buha/pir-trigger/README.md

# pir-trigger
Camera trigger using PIR sensor

# Specifications
* 2.7" Eink screen
* PIR sensor
* Light sensor
* Camera focus and shutter control (any camera with 2.5mm native or adapted cable release)
* 5 way navigational buttons
* \>1 year on a 3V CR2477
* Weatherproof
