buha/pir-trigger/doc/2.13inch_e-Paper_HAT_Schematic.pdf

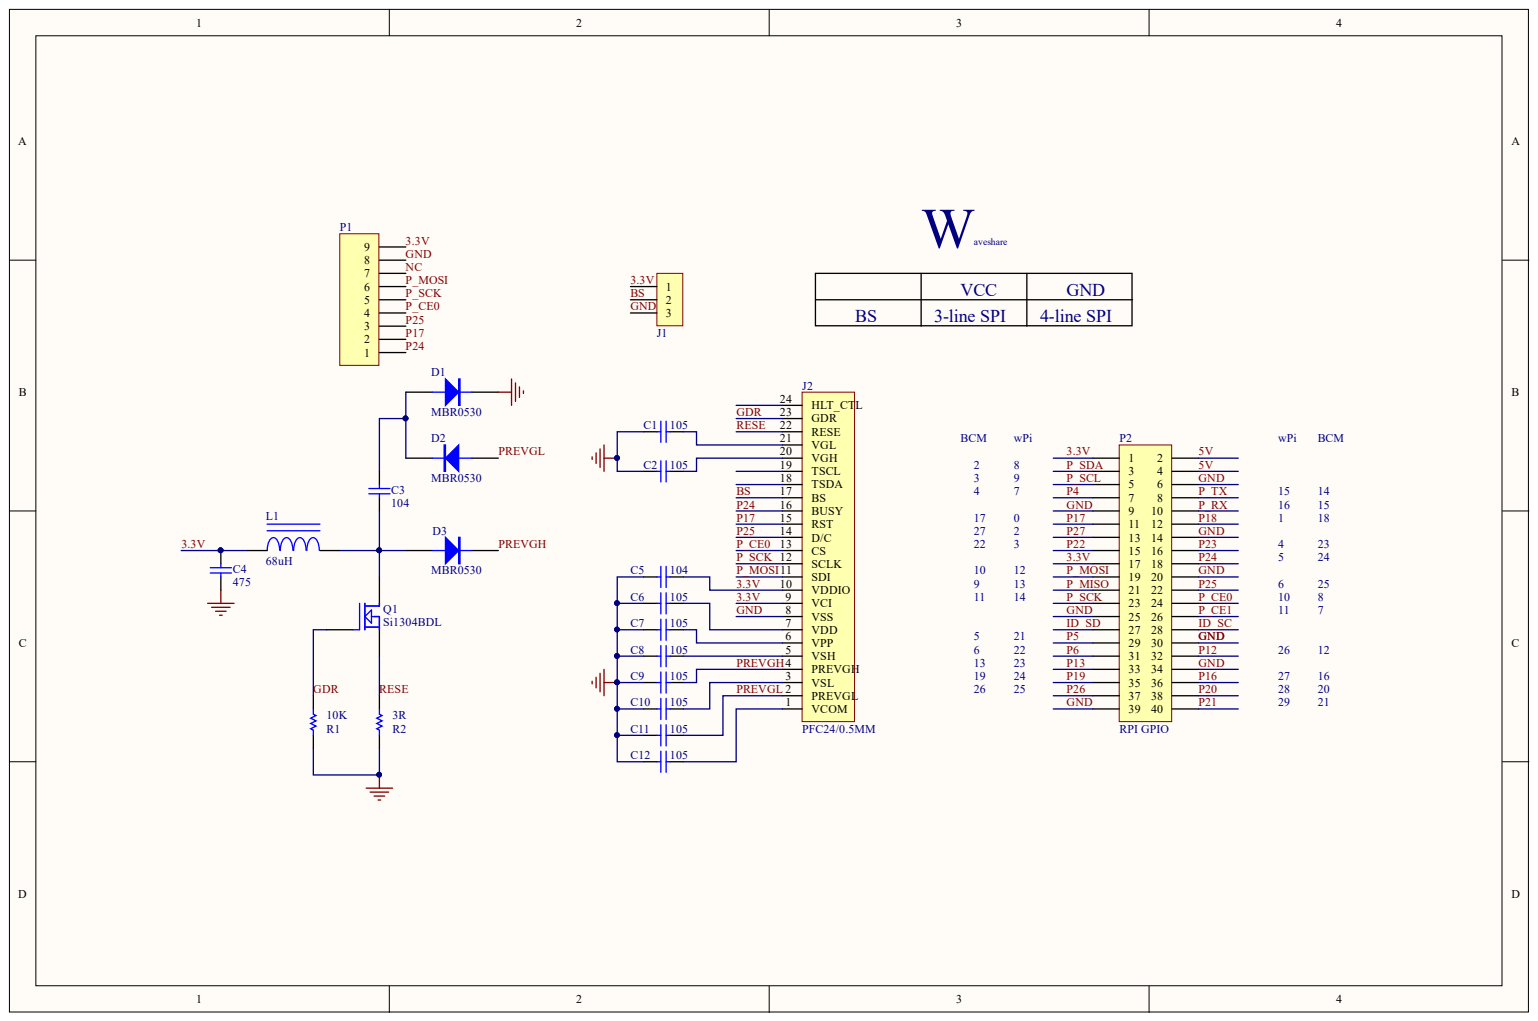
[picture p1: page 1]

PRE V G L | 2
