buha/pir-trigger/pcb/sim/st-design.asc

C1: cap; 47nF
C2: cap; 22µF
C3: cap; 22µF
C4: cap; 47nF
C5: cap; 10nF
C6: cap; 10nF
C8: cap; 3.5nF
D1: diode
R1: res; 680k
R2: res; 13k
R3: res; 13k
R4: res; 56k
R5: res; 680k
R6: res; 220k
R7: res; 470k
R8: res; 470k
R9: res; 220k
U1: AD8629
U2: AD8629
U3: LT1018
U4: LT1018
V1: voltage; PWL file=Z:\home\dari\Work\pir-trigger\pcb\sim\sensor-output.csv
V2: voltage; 3
Named nets: 0, PIR, VCC, stage1, stage2, stage3h, stage3l
.tran 0 100 0
.step param R1 list 10k 100k
