buha/pir-trigger/pcb/sim/ti-design.asc

C1: cap; 0.01µF
C2: cap; 33µF
C3: cap; 3.3µF
C4: cap; 1nF
C5: cap; 0.1µF
C6: cap; 0.1µF
C7: cap; 0.1µF
D1: diode
R1: res; 10k
R2: res; 6.81k
R3: res; 68.1k
R4: res; 1.3Meg
R5: res; 15Meg
R6: res; 15Meg
R7: res; 15Meg
R8: res; 15Meg
R9: res; 15Meg
U1: AD8629
U2: AD8629
U3: LT1018
U4: LT1018
V1: voltage; PWL file=Z:\home\dari\Work\pir-trigger\pcb\sim\sensor-output.csv
V2: voltage; 3
Named nets: 0, PIR, VCC, stage1, stage2, stage3h, stage3l
.tran 0 100 0
