buha/pir-trigger/pcb/pir.kicad_pcb

## KiCad design pcb/pir.kicad_pcb (2018-02-23)

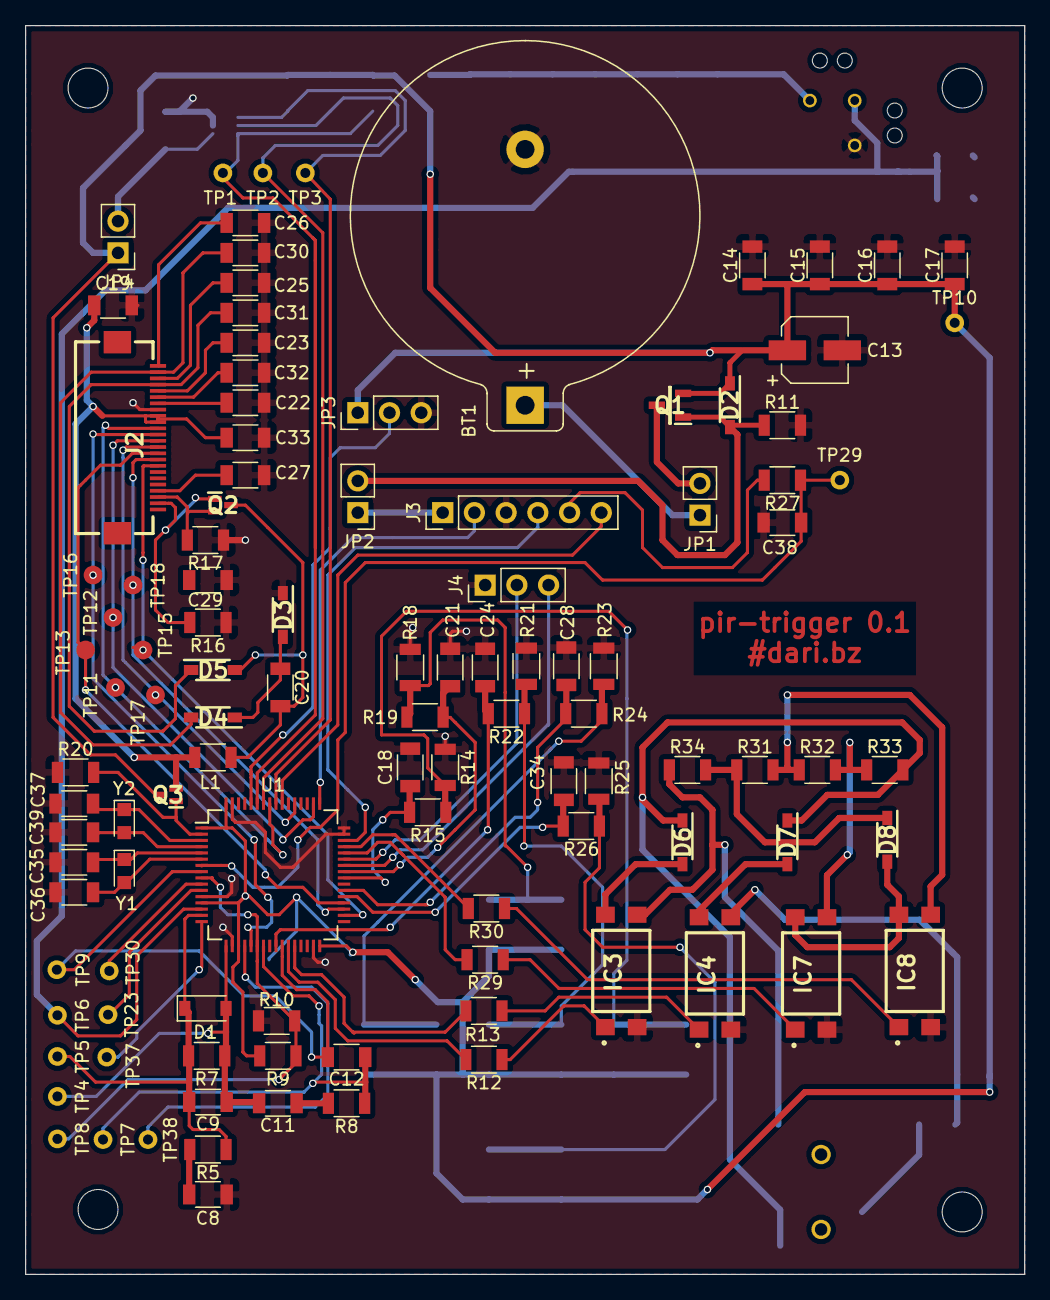
[picture p2: board pir.kicad_pcb from above]

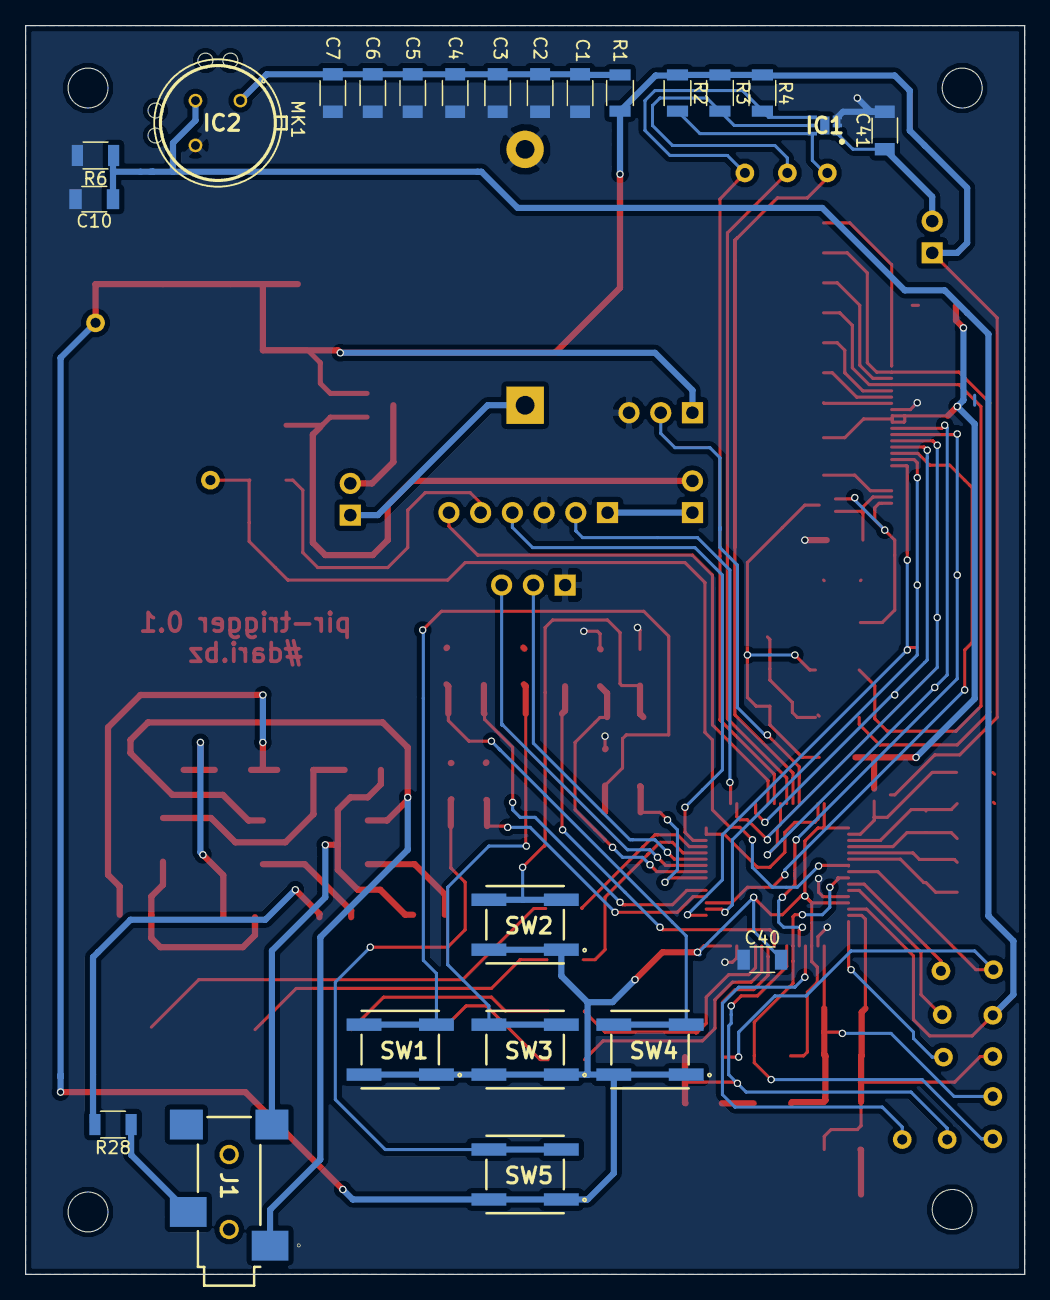
[picture p3: board pir.kicad_pcb from below]

Board: 2 copper layers, 80.0 x 100.0 mm, 133 parts (25 on the bottom side), 84 nets.

Parts:
BT1: CR2477 3V Battery; Keystone_105_1x2430-CoinCell
C1: 100μF; C_1206
C2, C14: 10μF; C_1206
C3, C15: 1μF; C_1206
C4, C16: 0.1μF; C_1206
C5, C17: 0.01μF; C_1206
C6: 1000pF; C_1206
C7: 100pF; C_1206
C8: 22μF; C_1206
C9, C12: 47nF; C_1206
C10: 3.3nF; C_1206
C11: 22uF; C_1206
C13: 100u; CP_Elec_5x5.3
C18, C21, C24, C28, C34, C38, C40: 100nF; C_1206
C19, C31: 4.7uF; C_1206
C20, C33: 100n; C_1206
C22, C23, C25, C26, C27, C29, C30, C32: 1uF; C_1206
C35, C36, C37, C39: 12pF; C_1206
C41: 0.1uF; C_1206
D1: 1N4148X-TP; D_SOD-123
D2, D3, D4, D5, D6, D7, D8: MBR0530; SOD3716X135N
IC1: MAX44009EDT+T; SON65P200X200X65-7N
IC2: IRA-S210ST01
IC3, IC4, IC7, IC8: EL817S
J1: SJ-2523-SMT-TR
J2: GDEW027W3; FH12A-24S-0.5SH
J3: SWD; Pin_Header_Straight_1x06_Pitch2.54mm
J4: UART; Pin_Header_Straight_1x03_Pitch2.54mm
JP1, JP2, JP4: Jumper; Pin_Header_Straight_1x02_Pitch2.54mm
JP3: Jumper_NC_Dual; Pin_Header_Straight_1x03_Pitch2.54mm
L1: 68uH; L_1206
MK1: IML-0688
Q1: SI2323DS; SOT95P237X112-3N
Q2, Q3: RE1C002UN; SOT50P160X85-3N
R1: 0; R_1206
R2, R3, R4, R15, R16, R19, R20, R22, R24, R26: 10k; R_1206
R5, R8: 13k; R_1206
R6: 56k; R_1206
R7: 680k; R_1206
R9, R10: 1M; R_1206
R11: 3.3K; R_1206
R12, R13, R28, R29, R30, R34: 150; R_1206
R14, R18, R21, R23, R25: 100k; R_1206
R17: 0.47; R_1206
R27: 1K; R_1206
R31: 36k; R_1206
R32: 2.9k; R_1206
R33: 2.2k; R_1206
SW1, SW2, SW3, SW4, SW5: SW_DPST-KSC931; KSC8(J)
TP1, TP2, TP3, TP4, TP5, TP6, TP7, TP8, TP9, TP10, TP23, TP29, TP30, TP37, TP38: TEST; Measurement_Point_Round-TH_Small
TP11, TP12, TP13, TP15, TP16, TP17, TP18: TEST; Measurement_Point_Round-SMD-Pad_Small
U1: STM32L476RETx; LQFP-64_10x10mm_Pitch0.5mm
Y1, Y2: 32 Mhz; Crystal_SMD_2012-2pin_2.0x1.2mm_HandSoldering

Connections:
/battery/Debugger3V3: J3.1, JP2.1
/camera/FOCUS: R12.2, U1.27
/camera/PANAFOCUS: R30.2, U1.45
/camera/PANASHUTTER: R29.2, U1.44
/camera/SHUTTER: R13.2, U1.28
/sensor/Ambient: IC1.4, R4.2, TP3.1, U1.56
/sensor/OPAMP1+: C10.1, IC2.2, R6.1, TP6.1, U1.14
/sensor/OPAMP1-: C9.2, D1.1, R5.1, R7.2, TP5.1, U1.15
/sensor/OPAMP1OUT: C9.1, C11.2, D1.2, R7.1, TP4.1, U1.17
/sensor/OPAMP2+: R9.1, R10.2, TP8.1, U1.9, U1.22
/sensor/OPAMP2-: C12.1, R8.1, TP7.1, U1.23
/sensor/OPAMP2OUT: C12.2, TP9.1, U1.8, U1.26
/sensor/SCL: IC1.5, R3.2, TP2.1, U1.58
/sensor/SDA: IC1.6, R2.2, TP1.1, U1.59
/soc/Down: C34.2, R26.2, U1.37
/soc/EINK_BS: J2.8, TP15.1, U1.34
/soc/EINK_BUSY: J2.9, TP18.1, U1.35
/soc/EINK_CS: J2.12, TP12.1, U1.50
/soc/EINK_D/C: J2.11, TP17.1, U1.53
/soc/EINK_MOSI: J2.14, TP11.1, U1.57
/soc/EINK_PWR: Q3.1, R20.2, U1.2
/soc/EINK_RST: J2.10, TP13.1, U1.36
/soc/EINK_SCK: J2.13, TP16.1, U1.21
/soc/Left: C18.2, R15.2, U1.40
/soc/OK: C24.2, R22.2, U1.25
/soc/Right: C28.2, R24.2, U1.38
/soc/Up: C21.2, R19.2, U1.41
/user/EINK_VCC: C19.1, C33.1, J2.15, J2.16, L1.1, Q3.2
/user/GDR: J2.2, Q2.1, R16.2
/user/PREVGH: C31.2, D5.1, J2.21
/user/PREVGL: C30.2, D4.2, J2.23
/user/RESE: J2.3, Q2.2, R17.2
Earth: BT1.2, C1.2, C2.2, C3.2, C4.2, C5.2, C6.2, C7.2, C8.2, C10.2, C13.2, C14.2, C15.2, C16.2, C17.2, C18.1, C19.2, C21.1, C22.1, C23.1, C24.1, C25.1, C26.2, C27.1, C28.1, C29.2, C30.1, C31.1, C32.1, C33.2, C34.1, C35.1, C36.1, C37.1, C38.1, C39.1, C40.1, C41.2, D3.1, IC1.2, IC1.3, IC2.3, IC3.2, IC4.2, IC7.2, IC8.2, J2.17, J3.3, J4.1, JP3.3, R6.2, R10.1, R11.2, R14.1, R16.1, R17.1, R18.1, R20.1, R21.1, R23.1, R25.1, U1.12, U1.18, U1.31, U1.47, U1.48, U1.63
unnamed: BT1.1, JP1.1
unnamed: C1.1, C2.1, C3.1, C4.1, C5.1, C6.1, C7.1, IC2.1, R1.1
unnamed: C8.1, R5.2
unnamed: C11.1, R8.2
unnamed: C20.1, D3.2, D4.1
unnamed: C20.2, D5.2, L1.2, Q2.3
unnamed: C22.2, J2.18
unnamed: C23.2, J2.20
unnamed: C25.2, J2.22
unnamed: C26.1, J2.24
unnamed: C27.2, J2.4
unnamed: C32.2, J2.19
unnamed: C35.2, U1.5, Y1.1
unnamed: C36.2, U1.6, Y1.2
unnamed: C37.2, U1.3, Y2.1
unnamed: C38.2, R27.1, TP29.1, U1.7
unnamed: C39.2, U1.4, Y2.2
unnamed: C41.1, IC1.1, JP4.2
unnamed: D2.2, JP2.2, Q1.1, R11.1
unnamed: D6.2, IC3.4
unnamed: D7.2, IC4.4
unnamed: D8.1, R31.1, R34.2
unnamed: D8.2, IC7.4, IC8.4
unnamed: IC3.1, R12.1
unnamed: IC4.1, R13.1
unnamed: IC4.3, R28.2
unnamed: IC7.1, R29.1
unnamed: IC7.3, R32.2, R33.1
unnamed: IC8.1, R30.1
unnamed: IC8.3, R31.2, R32.1
unnamed: JP1.2, Q1.3
unnamed: JP3.2, U1.60
unnamed: R14.2, R15.1, SW1.2, SW1.3
unnamed: R18.2, R19.1, SW2.2, SW2.3
unnamed: R21.2, R22.1, SW3.2, SW3.3
unnamed: R23.2, R24.1, SW4.2, SW4.3
unnamed: R25.2, R26.1, SW5.2, SW5.3
unnamed: TP23.1, U1.11
unnamed: TP30.1, U1.10
unnamed: TP37.1, U1.16
unnamed: TP38.1, U1.20
RING: IC3.3, J1.2, R34.1
RX: J4.2, U1.43
SHIELD: D6.1, D7.1, J1.1, R33.2
SWCLK: J3.2, U1.49
SWDIO: J3.4, U1.46
SWO: J3.6, U1.55
TIP: J1.3, R28.1
TX: J4.3, U1.42
VCC: C13.1, C14.1, C15.1, C16.1, C17.1, C40.2, D2.1, JP3.1, JP4.1, Q1.2, Q3.3, R1.2, R2.1, R3.1, R4.1, R9.2, SW1.1, SW1.4, SW2.1, SW2.4, SW3.1, SW3.4, SW4.1, SW4.4, SW5.1, SW5.4, TP10.1, U1.1, U1.13, U1.19, U1.32, U1.64
nRESET: J3.5, R27.2
