buha/pir-trigger/firmware/stm32l476re/stm32l476re.ioc

Mcu.UserName=STM32L476RETx
PA0.GPIO_Label=OPAMP1+
PA0.Signal=OPAMP1_VINP
PA1.GPIO_Label=OPAMP1-
PA1.Signal=OPAMP1_VINM
PA10.Signal=USART1_RX
PA11.GPIO_Label=PANASHUTTER
PA11.Signal=GPIO_Output
PA12.GPIO_Label=PANAFOCUS
PA12.Signal=GPIO_Output
PA3.Signal=OPAMP1_VOUT
PA5.GPIO_Label=SCK
PA5.Signal=SPI1_SCK
PA6.GPIO_Label=OPAMP2+
PA6.Signal=OPAMP2_VINP
PA7.GPIO_Label=OPAMP2-
PA7.Signal=OPAMP2_VINM
PA8.GPIO_Label=KEY_UP
PA8.Signal=GPXTI8
PA9.Signal=USART1_TX
PB0.GPIO_Label=OPAMP2OUT
PB0.Signal=OPAMP2_VOUT
PB1.GPIO_Label=FOCUS
PB1.Signal=GPIO_Output
PB13.GPIO_Label=EINK_BS
PB13.Signal=GPIO_Input
PB14.GPIO_Label=EINK_BUSY
PB14.Signal=GPIO_Input
PB15.GPIO_Label=EINK_RST
PB15.Signal=GPIO_Output
PB2.GPIO_Label=SHUTTER
PB2.Signal=GPIO_Output
PB5.GPIO_Label=MOSI
PB5.Signal=SPI1_MOSI
PB6.GPIO_Label=SCL
PB6.Signal=I2C1_SCL
PB7.GPIO_Label=SDA
PB7.Signal=I2C1_SDA
PC0.GPIO_Label=OPAMP2OUT
PC0.Signal=ADCx_IN1
PC1.GPIO_Label=OPAMP2+
PC1.Signal=ADCx_IN2
PC12.GPIO_Label=EINK_DC
PC12.Signal=GPIO_Input
PC13.GPIO_Label=EINK_PWR
PC13.Signal=GPIO_Output
PC5.GPIO_Label=KEY_OK
PC5.Signal=GPXTI5
PC6.GPIO_Label=KEY_DOWN
PC6.Signal=GPXTI6
PC7.GPIO_Label=KEY_RIGHT
PC7.Signal=GPXTI7
PC9.GPIO_Label=KEY_LEFT
PC9.Signal=GPXTI9
