buha/pir-trigger/firmware/Src/input.h

/*
 * input.h
 *
 *  Created on: 14 Mar 2018
 *      Author: dari
 */

#ifndef _INPUT_H_
#define _INPUT_H_

typedef enum
{
	KEY_OK = 28,
	KEY_UP = 103,
	KEY_LEFT = 105,
	KEY_RIGHT = 106,
	KEY_DOWN = 108
} input_t;

#endif /* _INPUT_H_ */
