buha/pir-trigger/(commit log)

2018-02-03 KiCad project files and some components
    At this point it is not certain if I go with CC2540. EFR SoCs maybe?
    [battery.sch, camera.sch, pir.kicad_pcb, pir.sch, sensor.sch, soc.sch]
2018-02-03 Replaced CC2540F256RHAT with CC2541F128RHAT
    CC2540F256RHAT has a useless USB interface.
    CC2541F128RHAT has better radio power consumption and reduced flash,
    I don't need 256KB. Fingers crossed for some samples from TI.
    EFR32 Blue Gecko was the best alternative so far but I opted for TI
    because of its free CCS (versus IAR) environment. EFR32 has better
    radio power consumption than TI chips but worse standby current
    (1.4 vs 0.5 uA).
    [soc.sch]
2018-02-03 Added debugger interface
    [battery.sch, camera.sch, pir.sch, sensor.sch, soc.sch]
2018-02-03 User pushbutton
    [battery.sch, pir.sch, sensor.sch, soc.sch]
2018-02-03 Added some documentation + TODO's
    [soc.sch]
2018-02-04 Added light sensor with IIC interface
    [battery.sch, camera.sch, pir.sch, sensor.sch, soc.sch]
2018-02-04 Migrated project/libraries to KiCad nightly build
    Revision: 821668d96
    Reason being the simulator feature and the better library management.
    [battery.sch, camera.sch, pir.sch, sensor.sch, soc.sch]
2018-02-04 Added simulation for the battery/debugger switch
    [power.sch]
2018-02-04 Battery/debugger switch implemented
    [battery.sch, sensor.sch, soc.sch]
2018-02-04 Simulation stage 1
    [sensor.sch]
2018-02-04 Stage 1 works with qucsator & ngspice
    [sensor.sch]
2018-02-04 Stage 2 simulation implemented
    [sensor.sch]
2018-02-05 Added stage 3 to simulator
    [sensor.sch]
2018-02-05 Added simulation for the alternative comparator
    [sensor-alternative.sch]
2018-02-05 Simulation source improvement
    [sensor-alternative.sch]
2018-02-05 Forgot C2/R2 in simulation
    [sensor-alternative.sch]
2018-02-09 Added Qucs simulation for ST design
    [sensor-alternative.sch]
2018-02-09 Added digitized sensor output from ST AN
    The conclusion of all these simulations is that the stage1
    feedback resistor must be digitally configurable.
    Needs some care because changing that resistor actually
    changes the filter response and we want to filter out
    anything beyond ~0.5Hz-5Hz.
    [sensor-output.csv]
2018-02-09 Added E-Ink display
    [battery.sch, camera.sch, pir.sch, sensor.sch, soc.sch, user.sch]
2018-02-10 Added hierarchical signals for E-Ink
    [pir.sch, soc.sch]
2018-02-10 Reverted to KiCad 4.0.7
    + Reworked debouncing for pushbuttons
    [battery.sch, camera.sch, pir.sch, sensor.sch, soc.sch, user.sch]
2018-02-10 MCU change, again
    STM32L0 had quite a big problem, common reference for the comparators.
    Another minus was the missing SWO for debugging.
    STM32L4 has floating point, and most importantly, has embedded OPAMPS!
    This means I can directly plug in the filter to the analog inputs and
    everything is software. 2 opamps and 2 comparators (if needed).
    External circuitry would be minimal for the PIR sensor.
    It also means that I can read with the embedded 12-bit ADC the
    amplified values. Precision is not crucial, we are interested in dips
    and swells.
    [battery.sch, camera.sch, pir.sch, sensor.sch, soc.sch, user.sch]
2018-02-10 Sensor logic implemented using MCU opamps
    Of the ST PIR design I use the first 2 stages only, so no comparators.
    1st stage using OPAMP1
    2nd stage using OPAMP2
    OPAMP1 amplifies the sensor output around the DC component of the PIR
    sensor.
    OPAMP2 amplifies the stage 1 output around half of VCC.
    The output is then passed differentially to ADC which gives a
    difference between stage 2 output and VCC/2.
    This can be later converted into real volts by using the internal
    VREFINT of the MCU because VCC can be measured against it. ST has
    some (hopefully) cool factory calibration feature to compensate
    for temperature deviations of the ADC which makes all this
    possible without external sigma-delta AD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
    [sensor.sch, soc.sch]
2018-02-11 Reworked the front diagram
    [battery.sch, camera.sch, pir.sch, sensor.sch, soc.sch, user.sch]
2018-02-11 Renamed all components
    [battery.sch, camera.sch, pir.sch, sensor.sch, soc.sch, user.sch]
2018-02-11 Changed camera interface to use optocouplers
    [battery.sch, camera.sch, pir.sch, sensor.sch, soc.sch, user.sch]
2018-02-11 Replaced original PIR symbol and ran ERC tests
    [battery.sch, camera.sch, pir.sch, sensor.sch, soc.sch, user.sch]
2018-02-13 Added testpoints
    [battery.sch, camera.sch, pir.kicad_pcb, sensor.sch, soc.sch, user.sch]
2018-02-13 CvPcb crashes every time on launch
    This commit saves work just before trying out nightly kicad-git.
    [battery.sch, camera.sch, pir.sch, sensor.sch, soc.sch, user.sch]
2018-02-13 Assigned footprints to all components
    [battery.sch, camera.sch, pir.kicad_pcb, sensor.sch, soc.sch, user.sch]
2018-02-13 Put the first components on layout
    [camera.sch, pir.kicad_pcb]
2018-02-13 I think I found a way to have Panasonic interface
    Uses 2 more optocouplers, 3 more diodes and some current limiting
    resistors.
    [camera.sch, pir.sch, soc.sch, user.sch]
2018-02-14 Reassigned some footprints, added some libraries
    Normally I can start working on PCB.
    [battery.sch, camera.sch, pir.kicad_pcb, pir.sch, sensor.sch, soc.sch, user.sch]
2018-02-19 Fixed board dimensions
    [pir.kicad_pcb]
2018-02-19 Started placing some components, finally
    [pir.kicad_pcb, sensor.sch, soc.sch]
2018-02-20 More work on the PCB
    The opamp circuit is done.
    Currently working on camera interface.
    TODO: screen, buttons.
    [battery.sch, camera.sch, pir.kicad_pcb, pir.sch, sensor.sch, soc.sch, user.sch]
2018-02-20 Camera interface placement done.
    [pir.kicad_pcb]
2018-02-20 Finished the display components placement.
    [battery.sch, camera.sch, pir.kicad_pcb, pir.sch, sensor.sch, soc.sch, user.sch]
2018-02-20 Placed all components
    Still some routing to do though, and many TP's are not placed.
    [pir.kicad_pcb, user.sch]
2018-02-21 Very few routes remaining
    Many TP's will be removed due to lack of space.
    [pir.kicad_pcb]
2018-02-22 Routed what seem to be the last useful tracks
    [pir.kicad_pcb]
2018-02-22 OK button MOVED TO A WKUP pin. PCB routing done.
    DRC passed.
    Unconnected tracks : 0.
    [pir.kicad_pcb, soc.sch, user.sch]
2018-02-22 1 mounting hole was missing for some reason
    [pir.kicad_pcb]
2018-02-22 Changed buttons from Panasonic to C&K
    [battery.sch, camera.sch, pir.kicad_pcb, pir.sch, sensor.sch, soc.sch, user.sch]
2018-02-22 Gerber files for v0.1
    Not tagging yet, need to check some things
    [pir-B.Cu.gbr, pir-B.Mask.gbr, pir-B.SilkS.gbr, pir-Edge.Cuts.gbr, pir-F.Cu.gbr, pir-F.Mask.gbr, pir-F.SilkS.gbr, pir-NPTH.drl]
2018-02-23 Changed FPC display connector
    Same model from Hirose but Top-connect not Bottom-connect as it
    previously was. Huge mistake, got it in time.
    Created GDEW027W3 schematic symbol for the display.
    [battery.sch, camera.sch, pir.kicad_pcb, pir.sch, sensor.sch, soc.sch, user.sch]
2018-02-23 Regenerated gerbers after latest modifications
    [pir-B.Cu.gbr, pir-B.Mask.gbr, pir-B.SilkS.gbr, pir-Edge.Cuts.gbr, pir-F.Cu.gbr, pir-F.Mask.gbr, pir-F.SilkS.gbr, pir-NPTH.drl]
2018-03-05 v0.1 Prototype files sent to PCBWay
    [battery.sch, camera.sch, pir.sch, sensor.sch, soc.sch, user.sch]
2018-03-07 STM32Cube file
    Partial.
2018-03-07 Kind of finished the STM32Cube project
2018-03-07 Generated skeleton project from STM32CubeMX
    I'm more inclined to go with a bare Makefile instead of IDE plugins nonsense.
    The Makefile had many errors though but I managed to make arm-none-eabi-gcc
    compile/link the project.
    [main.h]
2018-03-10 KEY_OK is now SYS_WKUP5, timebase changed to TIM1
    Regenerated all code. As in this commit, the code can be regene-
    rated using the hal.ioc file loaded up in STM32CubeMX.
    This will add additional files, or modify existing ones. I need
    to make sure to put code under USER CODE and not otherwise.
    Makefile is heavily reworked due to bugs in CubeMX generation so
    that one has to be manually merged.
2018-03-10 Debugger - arm-none-eabi-gdb + openocd
    Tested, works under Code::Blocks and cli.
    C::B needs `make debug` executed in a separate terminal.
    Working on improving this to automate the shutdown of
    openocd on debugger detach.
2018-03-11 Some changes to C::B prj file
    May change to Eclipse due to C::B issues:
    - doesn't properly parse preprocessor directives to grey out inactive code parts
    - no easy way to hard reset target device
    - starting freertos scheduler brings me back to main (might not be related to C::B)
2018-03-11 Watchdog was messing C::B debugger
    fixed.
    [firmware.ioc]
2018-03-12 Some temporary work in camera interface
    Shutter fires on my Nikon D600 but focus doesn't .. focus. It does
    something on camera, but it doesn't focus the lens at least.
    [main.h]
2018-03-13 Polishing of the camera interface + settings
    Camera interface settings are stored in the *settings* module and
    all that goes into/out of it gets through some functions. For now
    the functions are basic but semaphores will be added later.
    This commit also adds intervalometer style parameters to the
    trigger settings and can now accomodate for all sort of inter-delays
    in-between and repetition of triggers.
2018-03-15 Addded & tested EXTI interrupts for buttons
    OK doesnt show up, maybe some soldering issue, will fix that.
    [input.c, input.h]
2018-03-16 Excluded some CMSIS unused device headers
    Indexer was going crazy by showing too many results on F3.
2018-03-16 KEY_OK is now producing interrupts
    In cubemx I have configured it as SYS_WKUP (which is true) but this
    cubemx then removed it from the list of pins that should generate
    EXTI.
2018-03-16 Implemented input -> core ipc queue
    I can now pass info about what key was pressed between the tInput
    and tCore tasks.
    On problem I encountered was the fact that FreeRTOS blocks the
    usage of some of its ISR API if the NVIC Priority is above a certain
    threshold. In my case the threshold is 5 so I just modified the
    priority of the EXTI interrupt to 5 to allow that API subset to
    function properly.
    The queues are currently implemented using dynamic allocation and
    I fucking hate that, doesn't make sense to allocate/deallocate
    every time I send an 8 byte message. Need to investigate how good
    (if any) is the support of cmsis_os for FreeRTOS static allocations.
    [global.h, input.c, ipc.h]
2018-03-27 Work in ADC + created sensor task
    No results yet because fSensor is not executed.
2018-03-28 Increased heap size for FreeRTOS
    It failed to create its IDLE task, this is why I had issues executing
    the new fSensor task.
    [sensor.c]
2018-03-28 Added DMA configuration for ADC
    DMA interrupts don't fire, something is still wrong.
