buha/pir-trigger/(notices)

Notices in the files:
firmware/Inc/main.h:
Copyright (c) 2018 STMicroelectronics International N.V.
All rights reserved.
(C) COPYRIGHT STMicroelectronics *****END OF FILE
